wlhong-allo/jetson-orin-desktop-lekiwi-case/bambu-studio/Seeed-Studio-reComputer-Jetson-Orin-NX-Case-Lekiwi.3mf

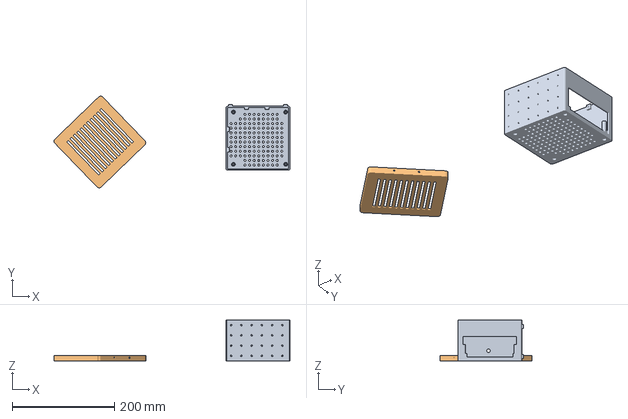
[picture p9: CAD file, 2026-10-12]
bambu-studio/Seeed-Studio-reComputer-Jetson-Orin-NX-Case-Lekiwi.3mf
460.7 x 179.2 x 80.0 mm
base.stl
cover.stl
