wlhong-allo/jetson-orin-desktop-lekiwi-case/stl/cover.stl

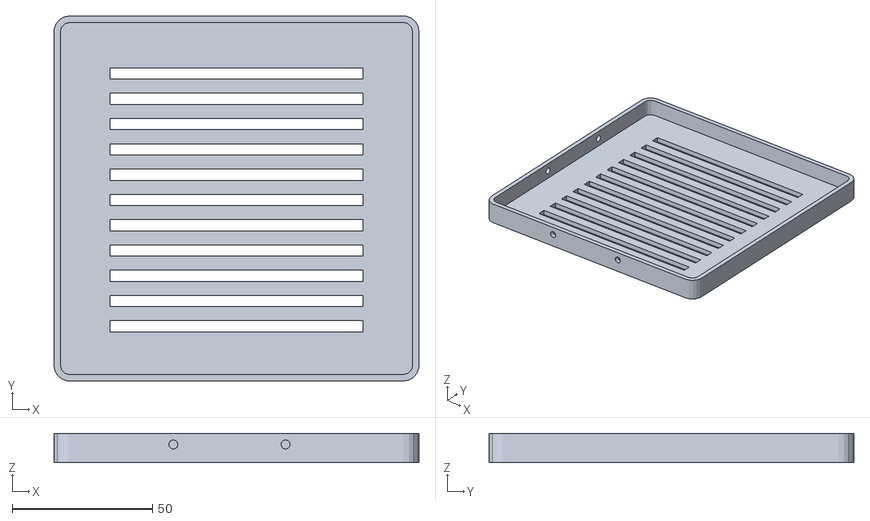
[picture p10: CAD file, 2026-10-12]
stl/cover.stl
130.0 x 130.0 x 10.5
