wlhong-allo/jetson-orin-desktop-lekiwi-case/stl/base.stl

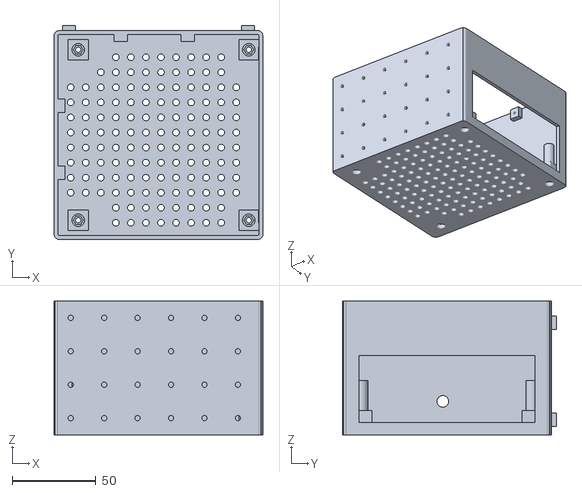
[picture p11: CAD file, 2026-10-12]
stl/base.stl
125.0 x 128.0 x 80.0
