wlhong-allo/jetson-orin-desktop-lekiwi-case/(list of files, cad)

Other CAD files:
cad/Jetson_Orin_NX_Case.scad
