wlhong-allo/jetson-orin-desktop-lekiwi-case/docs/images/step4_board_fan.jpg

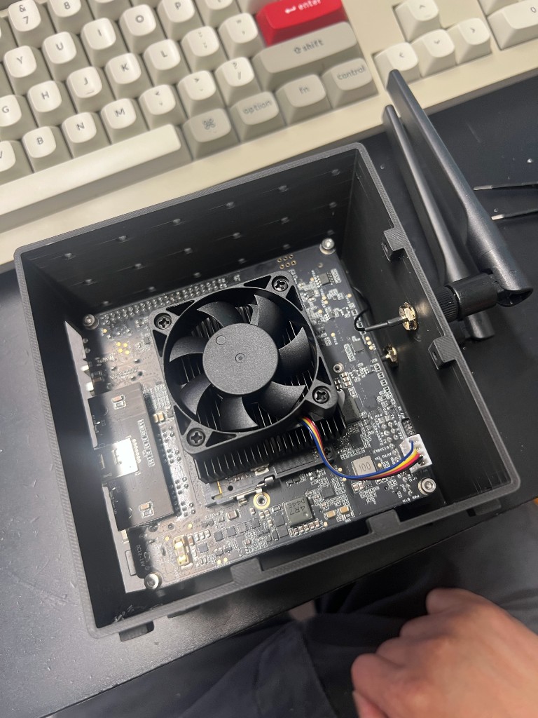
docs/images/step4_board_fan.jpg
