wlhong-allo/jetson-orin-desktop-lekiwi-case/(commit log)

2026-10-11 Initial commit: Jetson Orin NX case SCAD + build script
    [Jetson_Orin_NX_Case.scad]
2026-10-11 Reorganize repo for open-source release
    [Jetson_Orin_NX_Case.scad, base.stl, cover.3mf, cover.stl]
2026-10-11 Fix cover orientation, skirt screw axis, and footing placement
    - Move cover top plate to sit on top of base (z=oz), skirt hangs below,
    keeping skirt screws aligned with base pilots.
    - Size cover plate to skirt outer so it fully overlaps the skirt ring.
    - Add cover_print() (flipped) as default for part=cover to avoid the
    125mm bridge across the open interior; cover_design keeps the design
    orientation.
    - Fix screw_z to iz + 2*wall - skirt_h/2 so the screw axis is centered
    in the fully-enclosed skirt.
    - Move top pair of feet below the skirt and raise foot_h so the case
    stands on the feet, not the skirt edge.
    [Jetson_Orin_NX_Case.scad, base.stl, cover.stl]
2026-10-11 Add 2x 6mm WiFi antenna holes on -X wall
    Two 6mm holes on the -X wall (opposite the IO cutout) at y=60, z=20 and
    z=60, for SMA-style antenna connectors or cable glands.
    [Jetson_Orin_NX_Case.scad, base.stl]
2026-10-12 update: enlarge antenna hole to make it easier to install
    [Jetson_Orin_NX_Case.scad]
2026-10-12 fix: cover screw holes position bug fix
    [Jetson_Orin_NX_Case.scad, base.stl, cover.3mf, cover.stl]
2026-10-12 chore: update docs, bom and ref photos
2026-10-12 chore: update assembly instruction with photos
2026-10-12 chore: update 3mf file name
    [Seeed-Studio-reComputer-Jetson-Orin-NX-Case-Lekiwi.3mf]
